lukasdante/esp32-lifevest-telemetry-2/docs/ad8232_plot.png

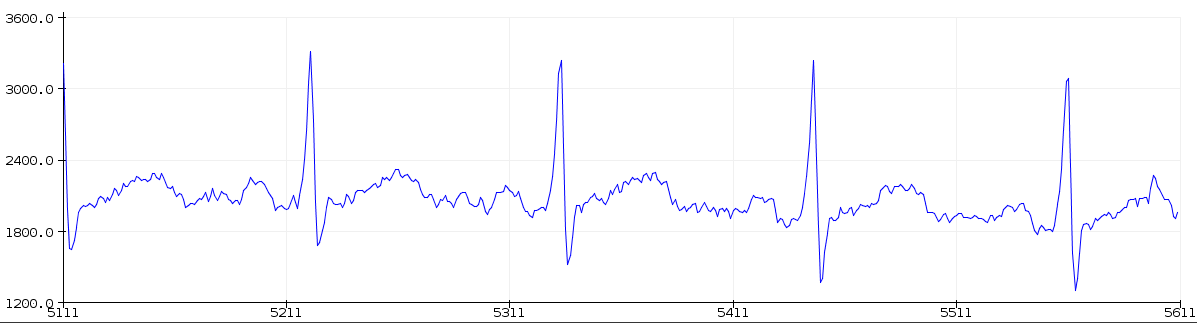
docs/ad8232_plot.png
