lukasdante/esp32-lifevest-telemetry-2/docs/schematic.pdf

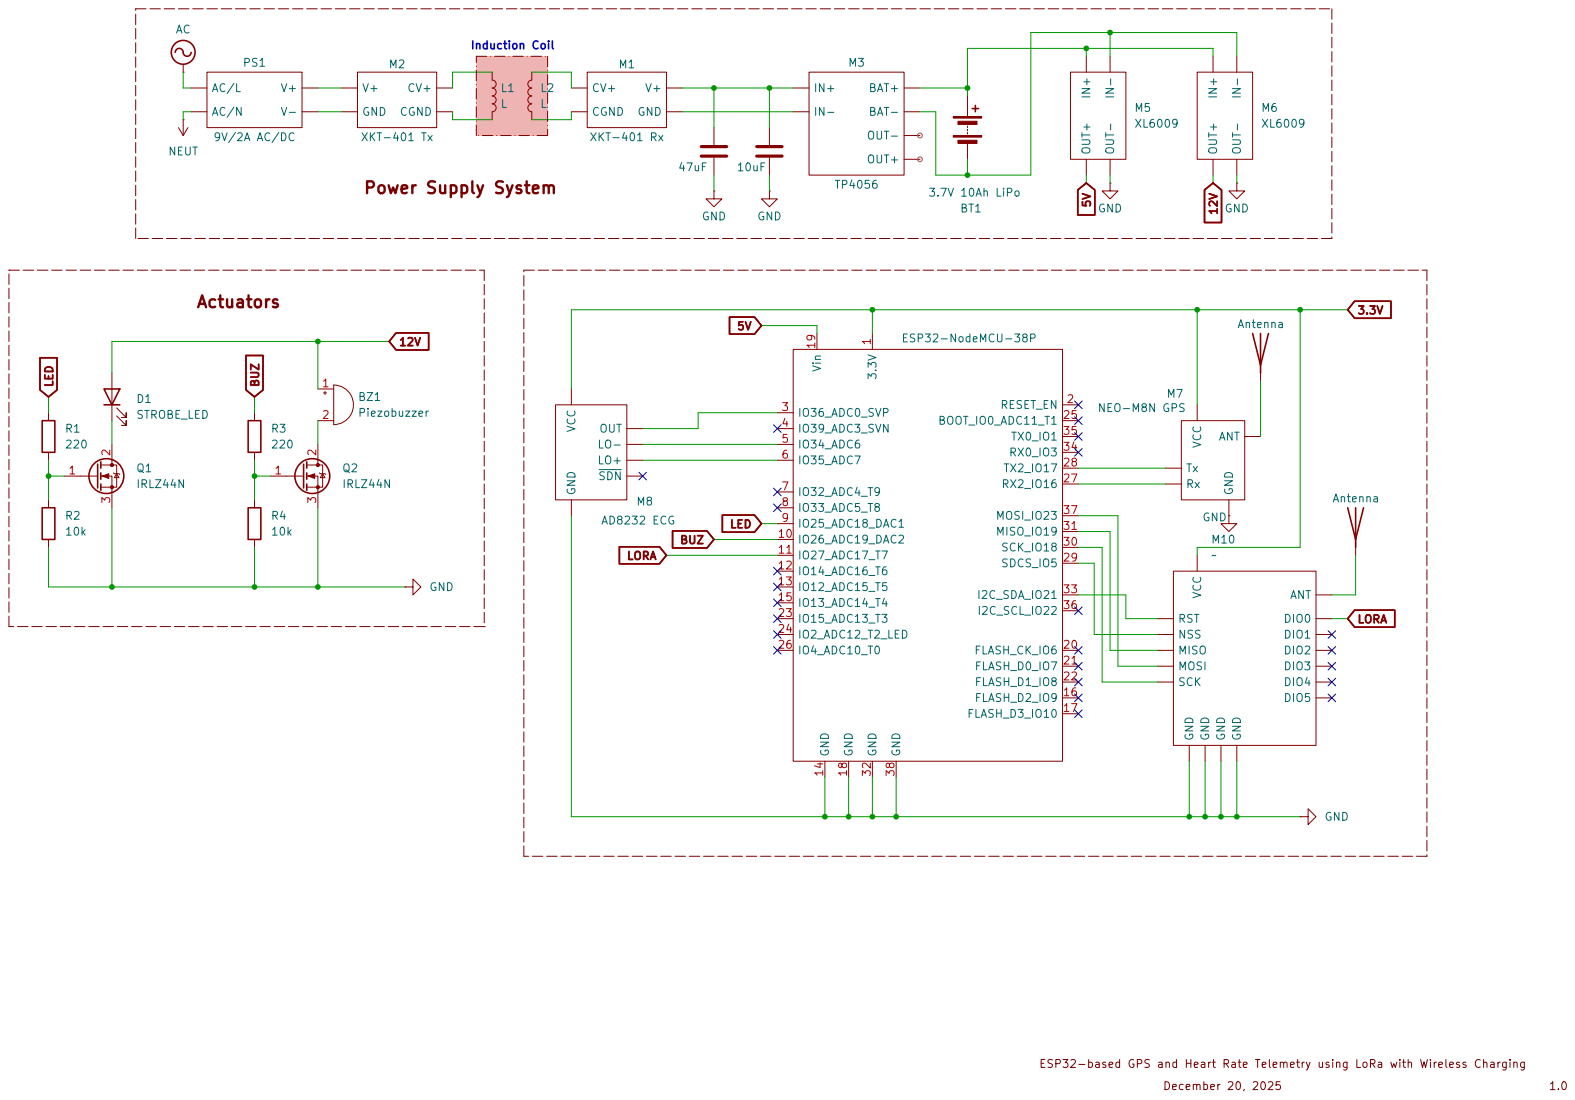
[picture p14: page 1]
